LaurillaUwU/KUV-printed-base/blender/render_girado.png

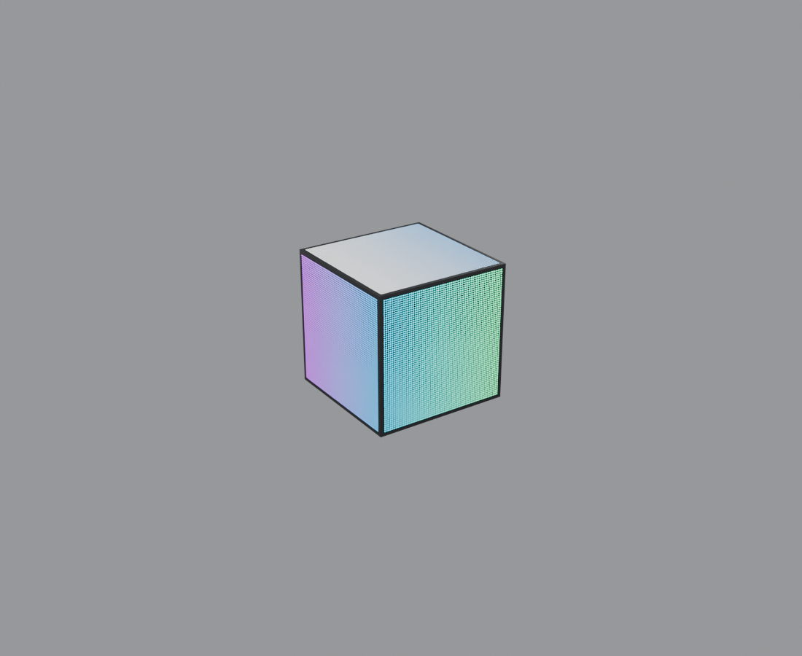
blender/render_girado.png
