LaurillaUwU/KUV-printed-base/blender/render_montado.png

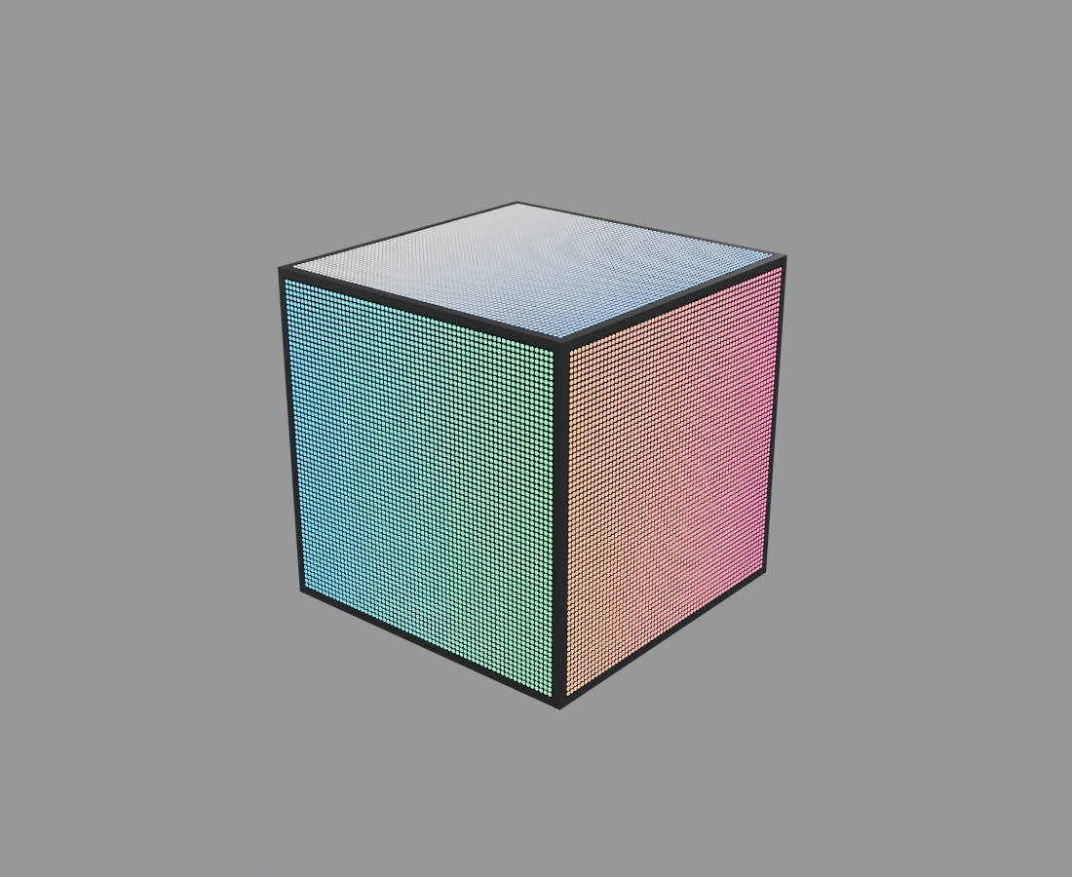
blender/render_montado.png
