LaurillaUwU/KUV-printed-base/imprimir/06_placa_inferior.stl

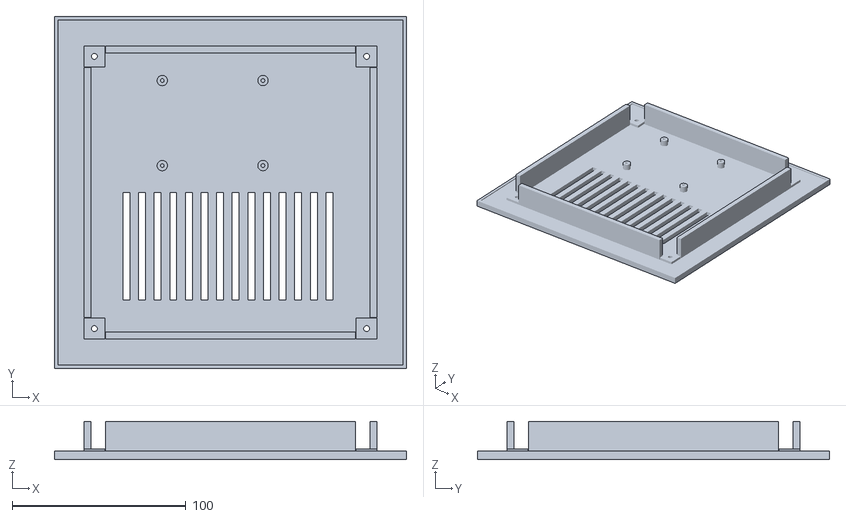
[picture p4: CAD file, 2026-11-04]
imprimir/06_placa_inferior.stl
202.8 x 202.8 x 22.0
