LaurillaUwU/KUV-printed-base/blender/stl/panel_side_0.stl

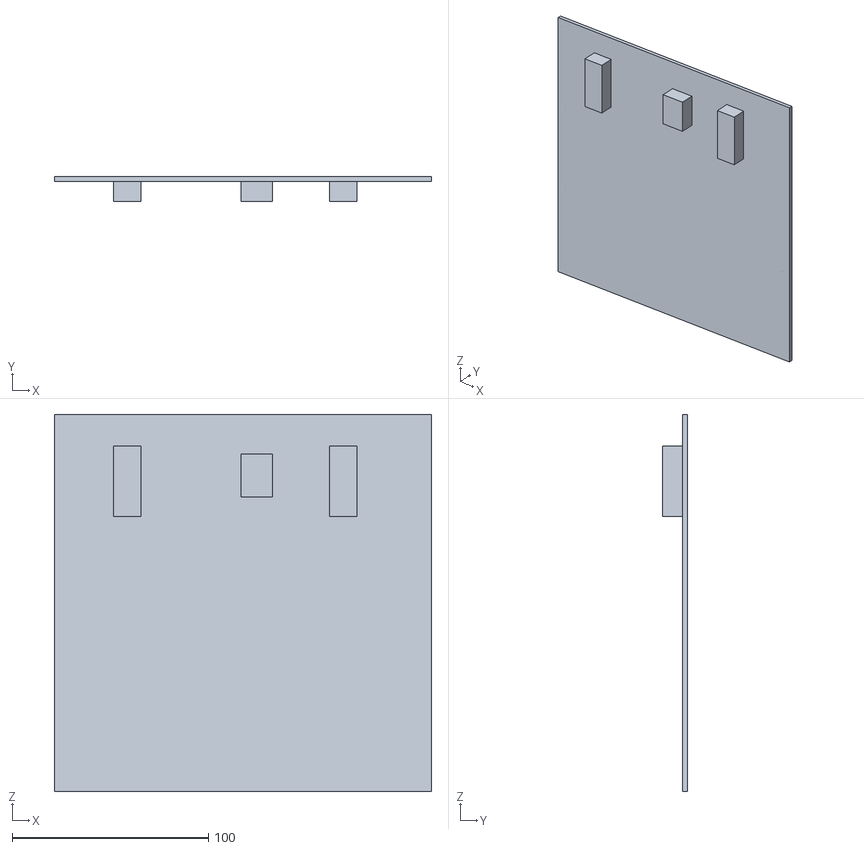
[picture p5: CAD file, 2026-11-04]
blender/stl/panel_side_0.stl
192.0 x 12.5 x 192.0
