LaurillaUwU/KUV-printed-base/imprimir/02_probeta_calibracion.stl

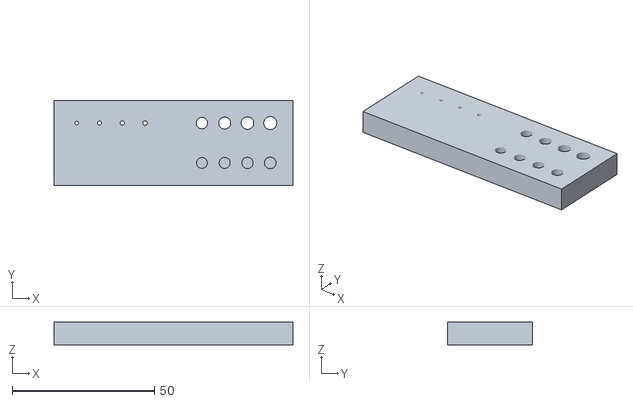
[picture p6: CAD file, 2026-11-04]
imprimir/02_probeta_calibracion.stl
84.0 x 30.0 x 8.00
