LaurillaUwU/KUV-printed-base/imprimir/04_portamatriz_lateral_B.stl

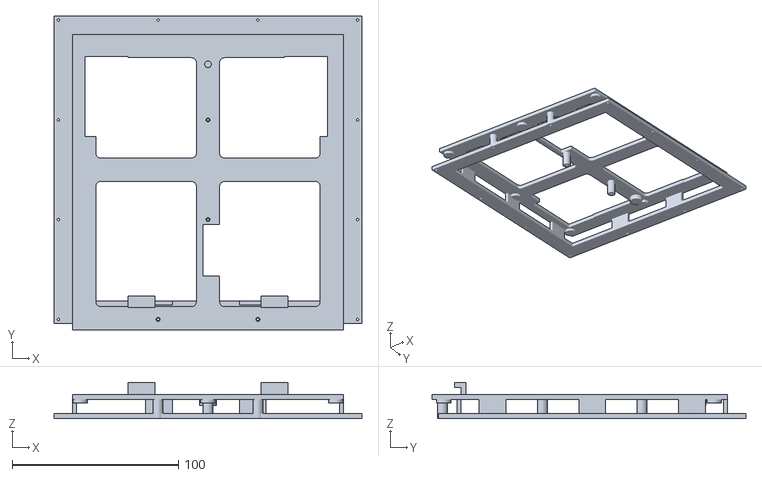
[picture p7: CAD file, 2026-11-04]
imprimir/04_portamatriz_lateral_B.stl
185.0 x 188.9 x 21.9
