LaurillaUwU/KUV-printed-base/blender/stl/holder_side_0.stl

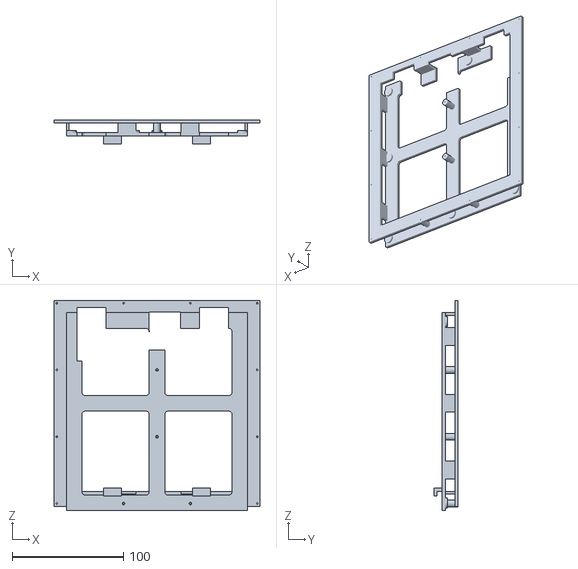
[picture p8: CAD file, 2026-11-04]
blender/stl/holder_side_0.stl
185.0 x 21.9 x 188.9
