LaurillaUwU/KUV-printed-base/imprimir/08_anillo_superior.stl

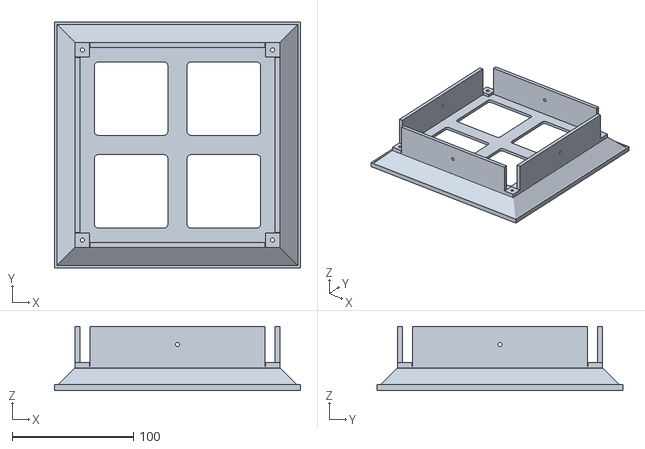
[picture p9: CAD file, 2026-11-04]
imprimir/08_anillo_superior.stl
202.8 x 202.8 x 53.0
