LaurillaUwU/KUV-printed-base/imprimir/05_portamatriz_superior_B.stl

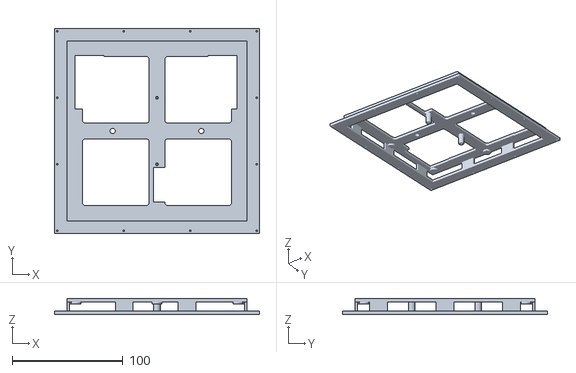
[picture p10: CAD file, 2026-11-04]
imprimir/05_portamatriz_superior_B.stl
185.0 x 185.0 x 14.5
