LaurillaUwU/KUV-printed-base/blender/stl/column_2.stl

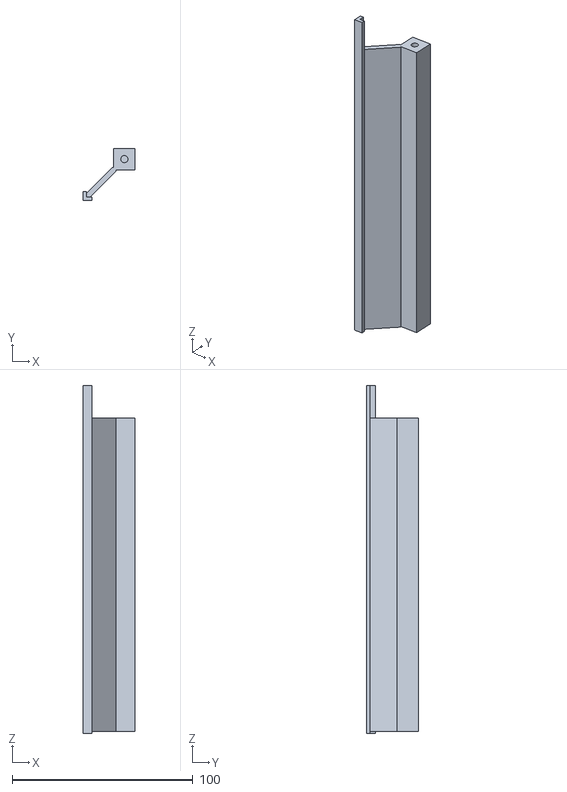
[picture p11: CAD file, 2026-11-04]
blender/stl/column_2.stl
29.0 x 29.0 x 192.8
