LaurillaUwU/KUV-printed-base/imprimir/01_plantilla_prueba.stl

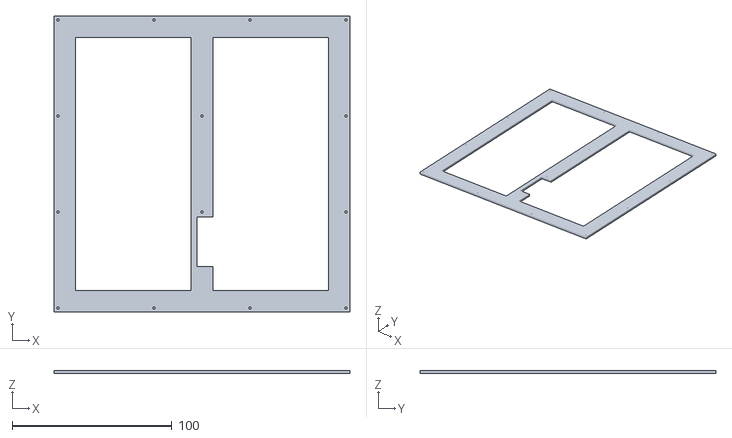
[picture p12: CAD file, 2026-11-04]
imprimir/01_plantilla_prueba.stl
185.0 x 185.0 x 2.00
