LaurillaUwU/KUV-printed-base/blender/stl/pi.stl

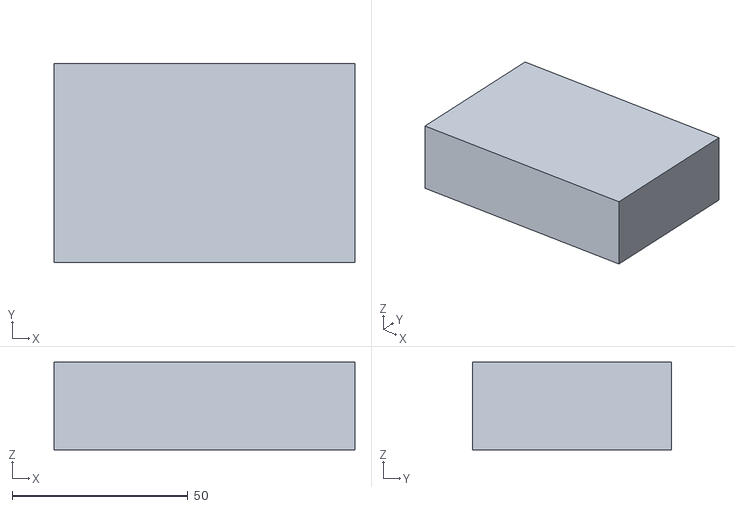
[picture p13: CAD file, 2026-11-04]
blender/stl/pi.stl
85.6 x 56.5 x 25.0
