LaurillaUwU/KUV-printed-base/(list of files, cad)

Other CAD files:
imprimir/07_columna.stl
blender/stl/panel_top.stl
blender/stl/holder_side_3.stl
imprimir/03_portamatriz_lateral_A.stl
blender/stl/bottom_plate.stl
blender/stl/holder_side_2.stl
blender/stl/panel_side_3.stl
blender/stl/holder_top.stl
blender/stl/column_0.stl
blender/stl/top_ring.stl
blender/stl/panel_side_1.stl
blender/stl/panel_side_2.stl
blender/stl/column_1.stl
blender/stl/holder_side_1.stl
blender/stl/column_3.stl
blender/cubo_v1.blend
blender/stl/screws_free_0.stl
blender/stl/screws_free_1.stl
blender/stl/screws_free_2.stl
blender/stl/screws_free_3.stl
blender/stl/screws_free_top.stl
blender/stl/screws_ok_0.stl
blender/stl/screws_ok_1.stl
blender/stl/screws_ok_2.stl
blender/stl/screws_ok_3.stl
blender/stl/screws_ok_top.stl
