LaurillaUwU/KUV-printed-base/(commit log)

2026-11-04 Cubo LED giratorio v1: diseño, escena de Blender, verificaciones y archivos de impresión
    - cubo_v1.scad: estructura impresa (placa, 4 columnas, anillo y 5 portamatrices) con los 14
    tornillos originales de cada matriz, aro bajo, imanes, uniones M3 y vistas de impresión.
    - blender/: escena cubo_v1.blend, renders y verificaciones automáticas (piezas sueltas,
    interferencias, parejas de imanes, uniones M3, secuencia de armado e impresión).
    - imprimir/: STL orientados para el slicer e INSTRUCCIONES.md.
    - calculos_retencion.py: resistencia de imanes, tornillos y uniones.
    [01_plantilla_prueba.stl, 02_probeta_calibracion.stl, 03_portamatriz_lateral_A.stl, 04_portamatriz_lateral_B.stl, 05_portamatriz_superior_B.stl, 06_placa_inferior.stl, 07_columna.stl, 08_anillo_superior.stl]
2026-11-04 README: tamaño mínimo de impresora
